ThomasWilkinson28/Autonomous-Manual-Gripper-Robot/CAD Model of Robot/backViewCAD.png

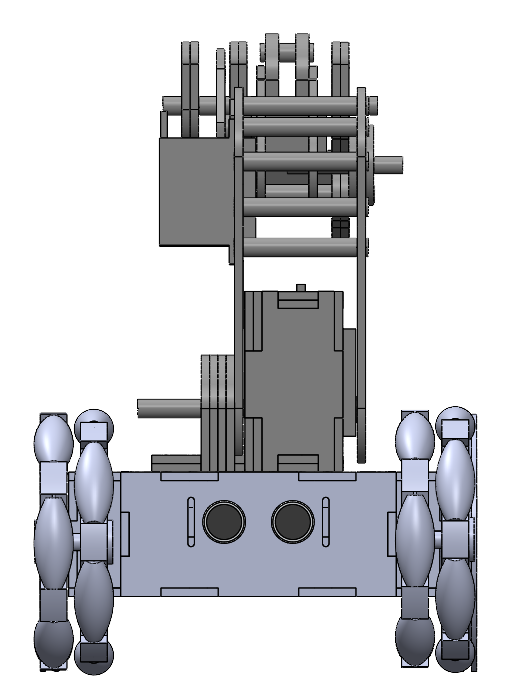
CAD Model of Robot/backViewCAD.png
