ThomasWilkinson28/Autonomous-Manual-Gripper-Robot/CAD Model of Robot/frontViewCAD.png

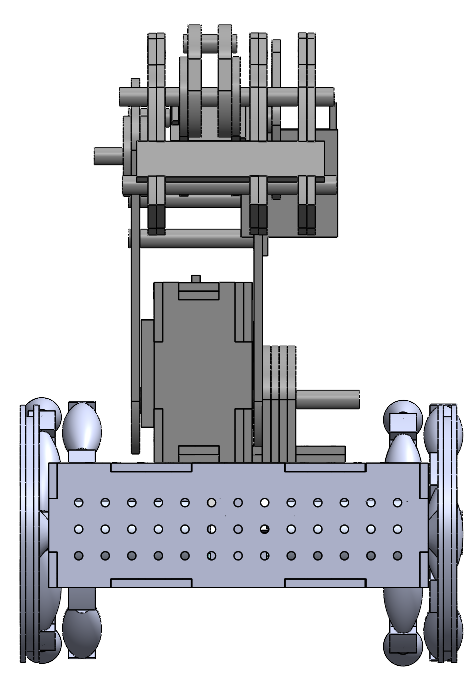
CAD Model of Robot/frontViewCAD.png
