ThomasWilkinson28/Autonomous-Manual-Gripper-Robot/CAD Model of Robot/ISOViewCAD.png

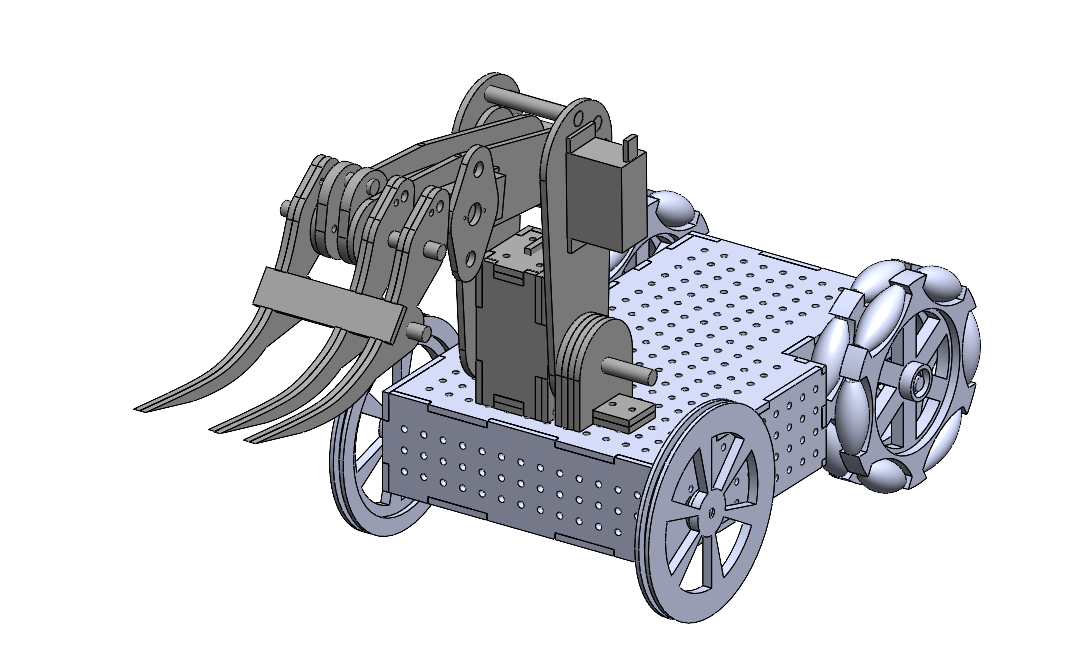
CAD Model of Robot/ISOViewCAD.png
