ThomasWilkinson28/Autonomous-Manual-Gripper-Robot/CAD Model of Robot/sideViewCAD.png

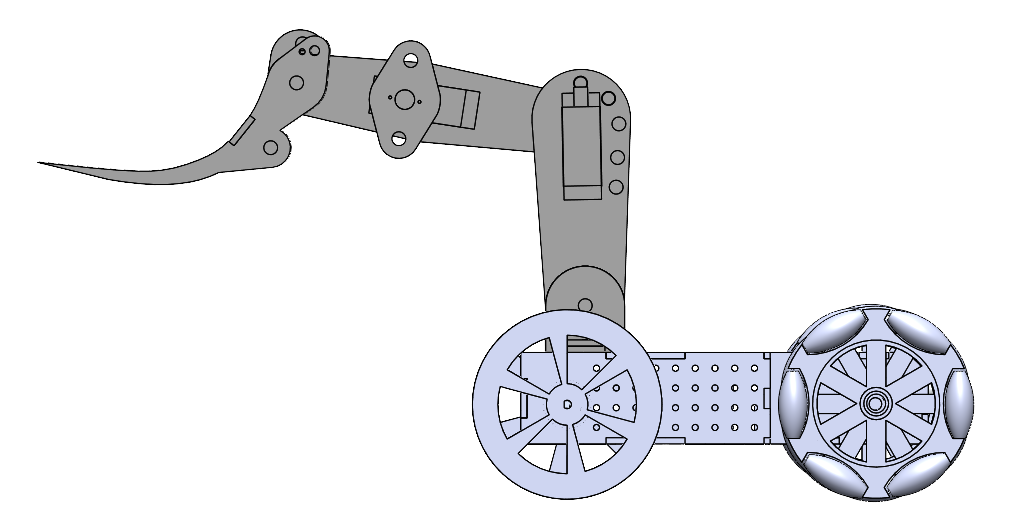
CAD Model of Robot/sideViewCAD.png
