ThomasWilkinson28/Autonomous-Manual-Gripper-Robot/CAD Model of Robot/topviewCAD.png

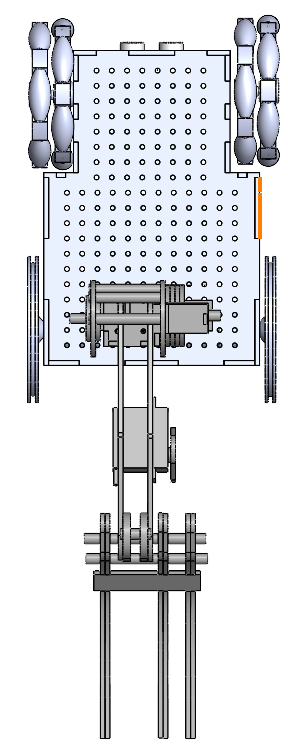
CAD Model of Robot/topviewCAD.png
