ThomasWilkinson28/Autonomous-Manual-Gripper-Robot/FinalDesign/FrontView.jpg

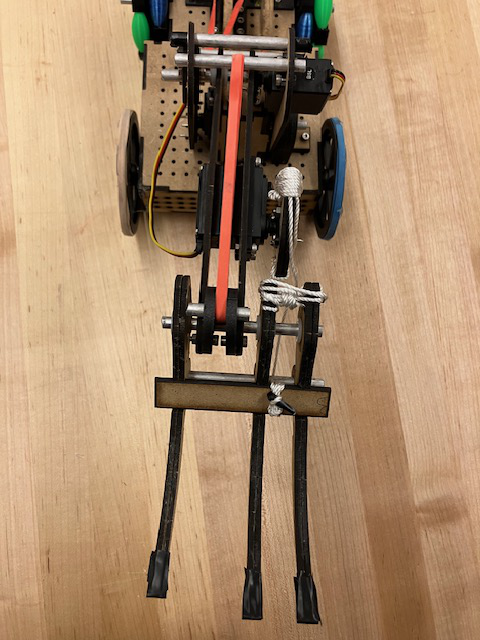
FinalDesign/FrontView.jpg
