ThomasWilkinson28/Autonomous-Manual-Gripper-Robot/FinalDesign/IsometricBackLeft.jpg

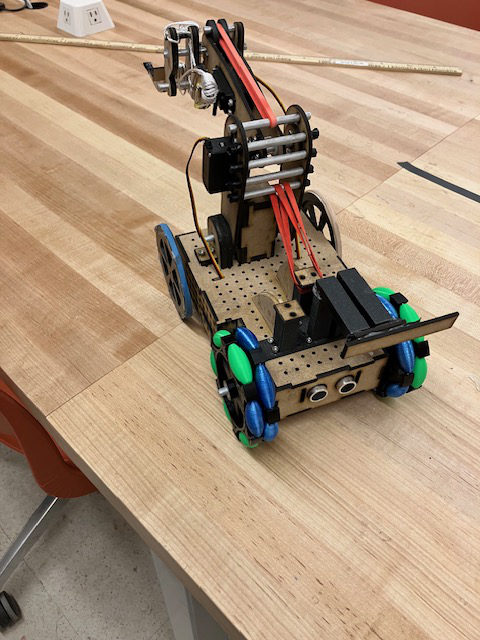
FinalDesign/IsometricBackLeft.jpg
