ThomasWilkinson28/Autonomous-Manual-Gripper-Robot/FinalDesign/IsometricLeft.jpg

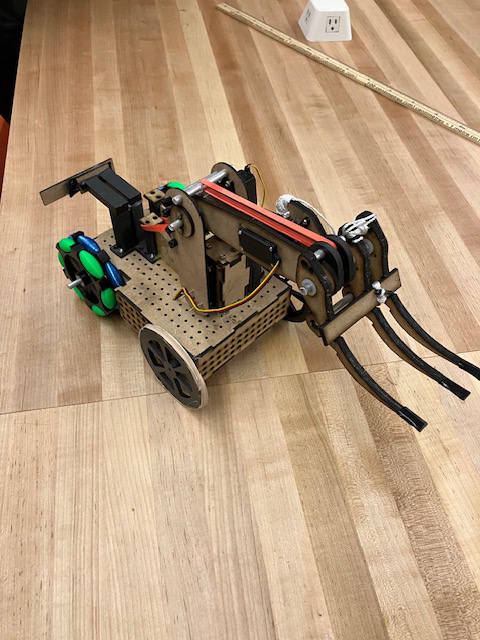
FinalDesign/IsometricLeft.jpg
