ThomasWilkinson28/Autonomous-Manual-Gripper-Robot/FinalDesign/OmniWheelsandBBumber.jpg

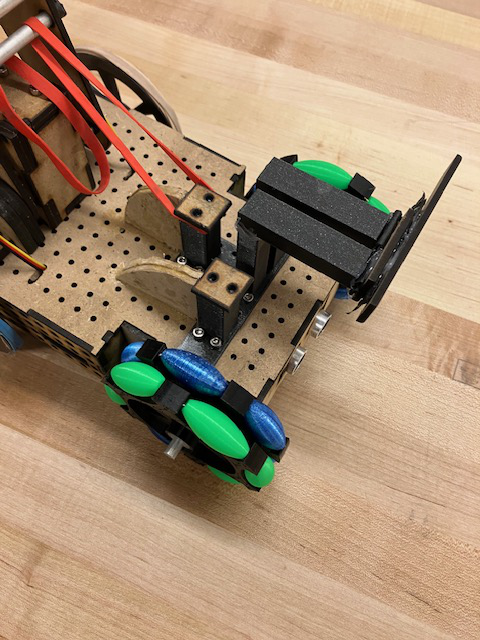
FinalDesign/OmniWheelsandBBumber.jpg
