ThomasWilkinson28/Autonomous-Manual-Gripper-Robot/FinalDesign/RoboticArm.jpg

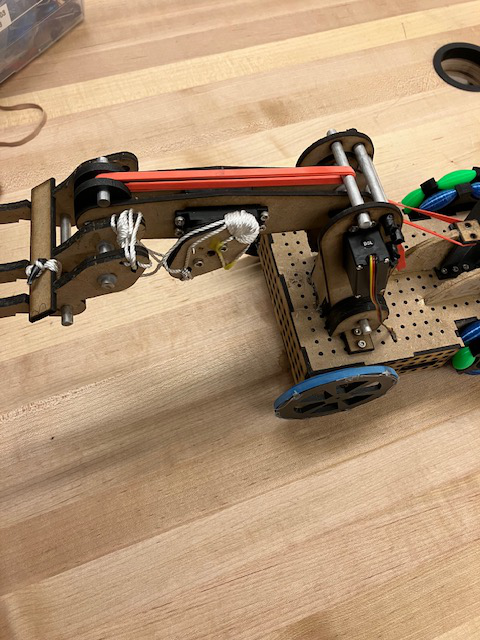
FinalDesign/RoboticArm.jpg
