ThomasWilkinson28/Autonomous-Manual-Gripper-Robot/FinalDesign/TopView.jpg

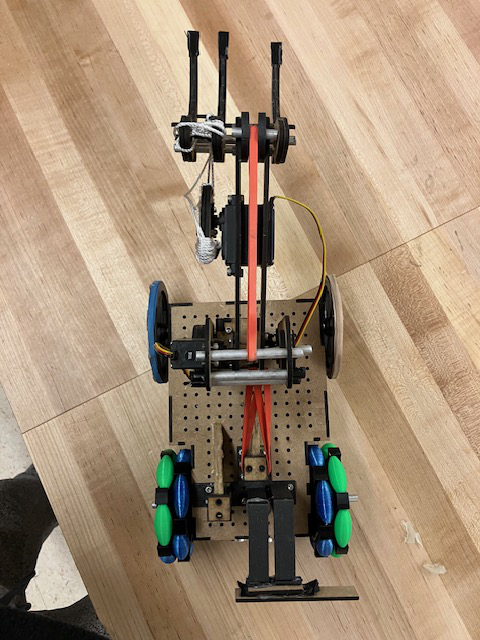
FinalDesign/TopView.jpg
