ThomasWilkinson28/Autonomous-Manual-Gripper-Robot/Round3/image.png

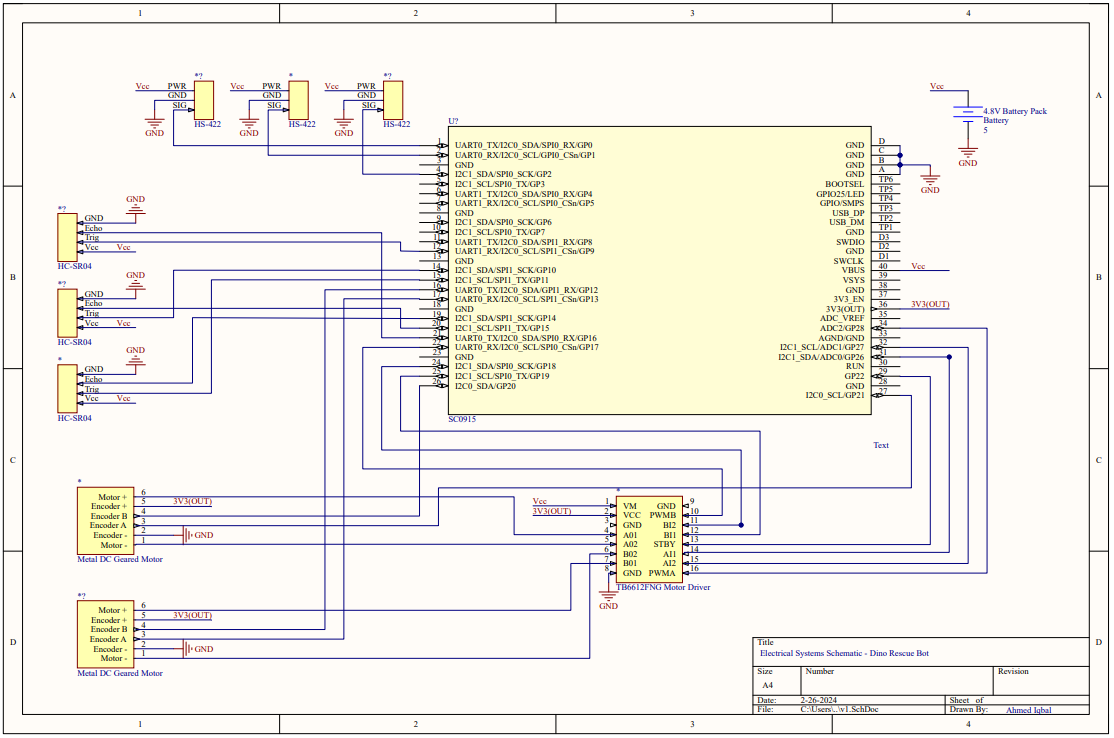
Round3/image.png
