ThomasWilkinson28/Autonomous-Manual-Gripper-Robot/AssembledPrototype/BackView.jpg

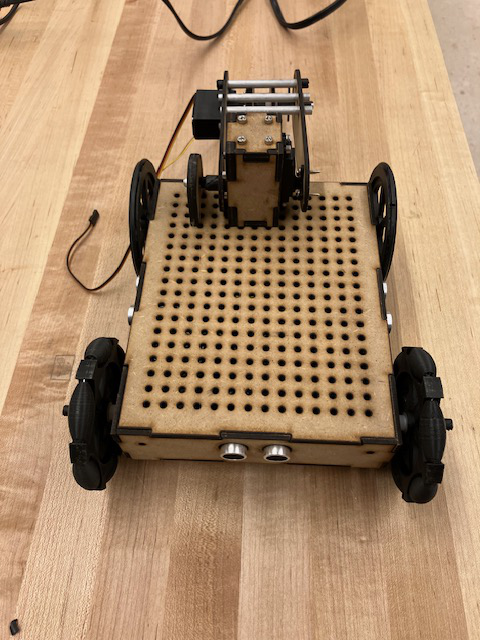
AssembledPrototype/BackView.jpg
