ThomasWilkinson28/Autonomous-Manual-Gripper-Robot/AssembledPrototype/FrontView.jpg

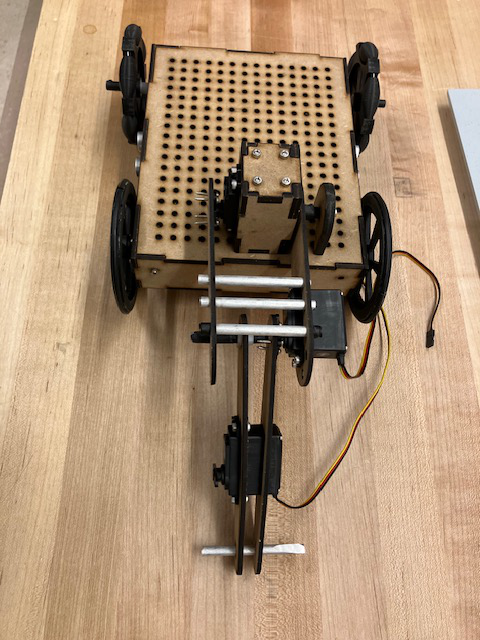
AssembledPrototype/FrontView.jpg
