ThomasWilkinson28/Autonomous-Manual-Gripper-Robot/AssembledPrototype/IsometricLeft.jpg

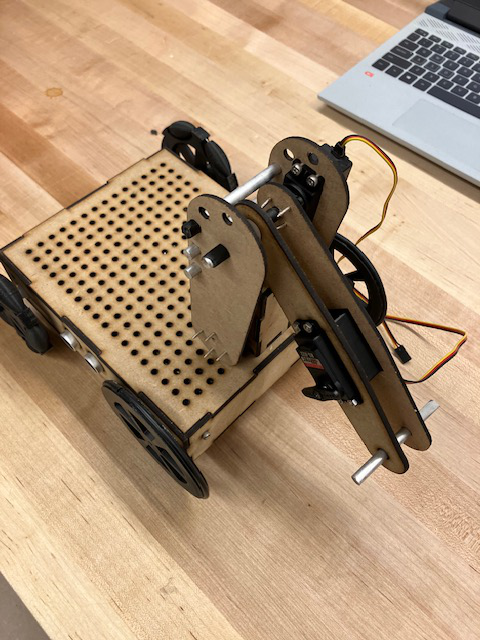
AssembledPrototype/IsometricLeft.jpg
