ThomasWilkinson28/Autonomous-Manual-Gripper-Robot/AssembledPrototype/IsometricRight.jpg

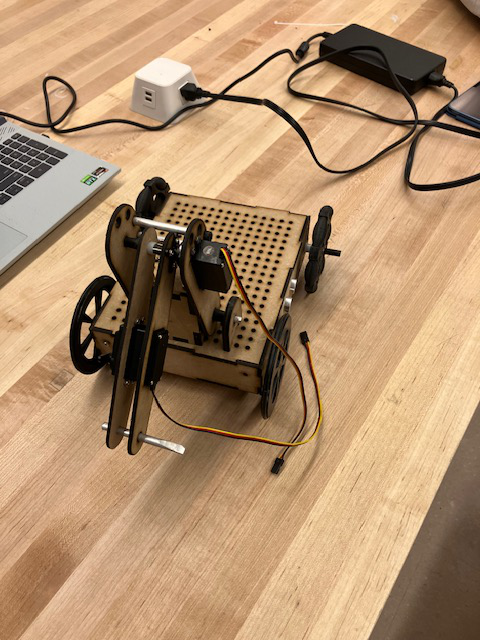
AssembledPrototype/IsometricRight.jpg
