ThomasWilkinson28/Autonomous-Manual-Gripper-Robot/AssembledPrototype/TopView.jpg

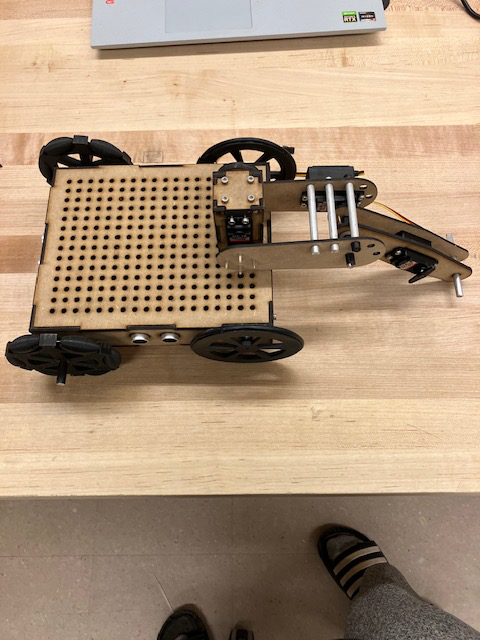
AssembledPrototype/TopView.jpg
