ThomasWilkinson28/Autonomous-Manual-Gripper-Robot/FinalDesign/InternalWiring.jpg

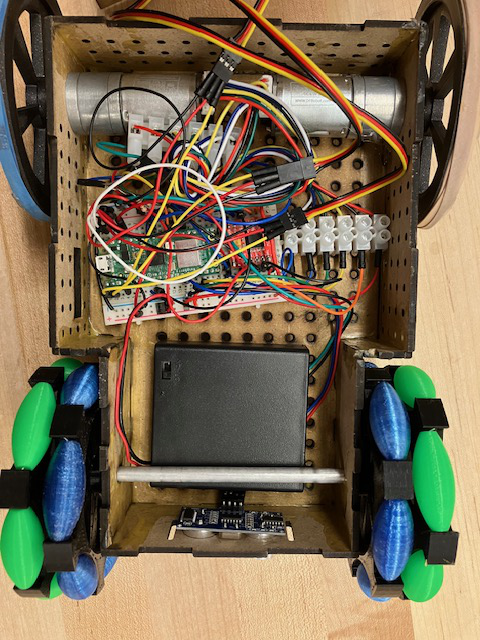
FinalDesign/InternalWiring.jpg
