ThomasWilkinson28/Autonomous-Manual-Gripper-Robot/Electronics/electrical schematics.pdf

I2C0_SCL/GP21 | 27 GND | 28 GP22 | 29 RUN | 30 I2C1_SDA/ADC0/GP26 | 31 I2C1_SCL/ADC1/GP27 | 32 AGND/GND | 33 ADC2/GP28 | 34 ADC_VREF | 35 3V3(OUT) | 36 3V3_EN | 37 GND | 38 VSYS | 39 VBUS | 40 SWCLK | D1 GND | D2 SWDIO | D3 GND | TP1 USB_DM | TP2 USB_DP | TP3 GPIO/SMPS | TP4 GPIO25/LED | TP5 BOOTSEL | TP6 GND | A

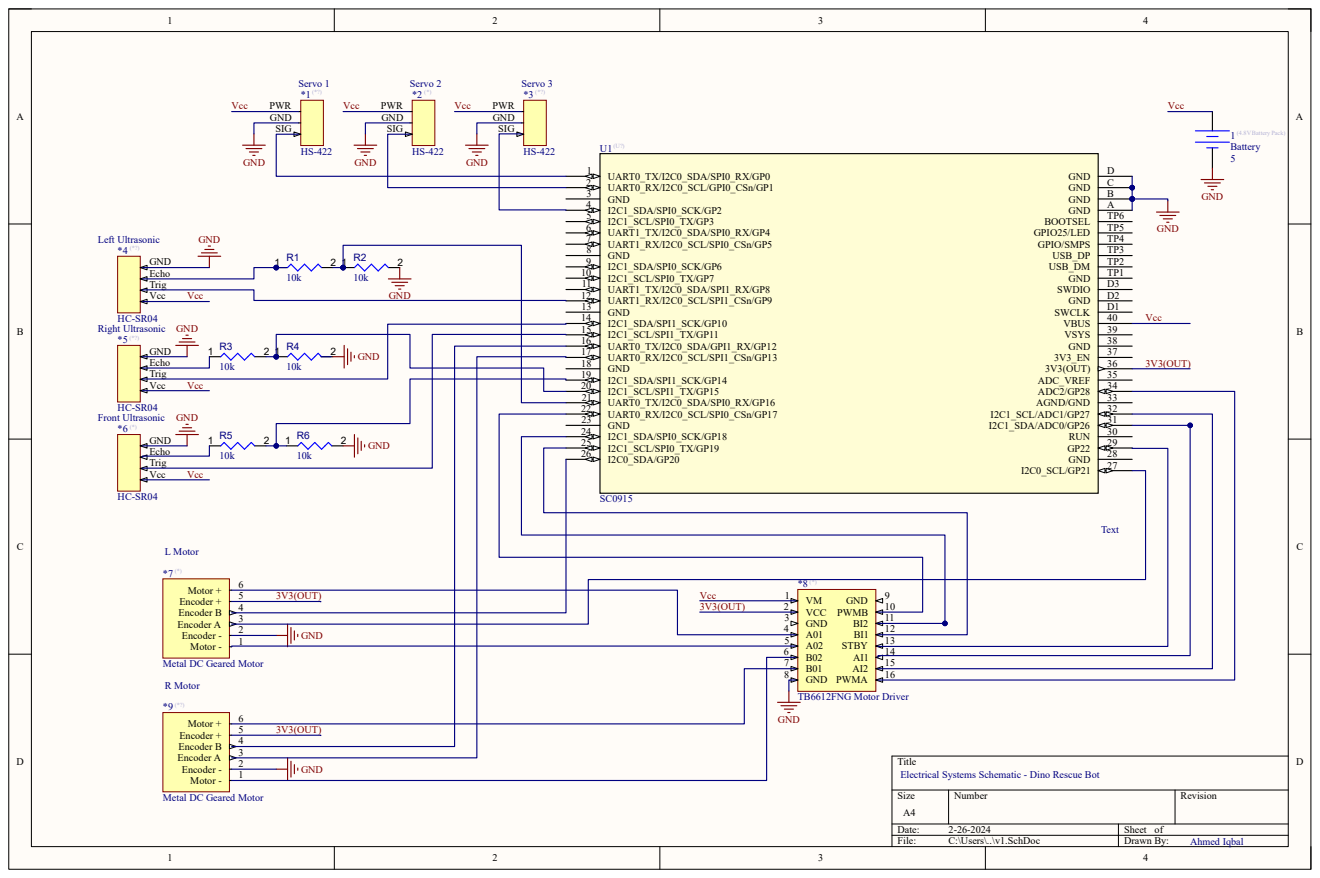
[picture p39: page 1]
Size; Number; Revision; Date:; Sheet of; File:; C:\Users\..\v1.SchDoc; Drawn By: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

Metal DC Geared Motor

Title
Electrical Systems Schematic - Dino Rescue Bot
